TruckHacking/TruckDuckHardware/README.md

The TruckDuck hardware, introduced at the DEFCON24 Talk titled "Cheap Tools for Hacking Heavy Trucks" by SixVolts and Haystack.

Watch the presentation here: https://www.youtube.com/watch?v=PDlkcKtkeOE
