TruckHacking/TruckDuckHardware/Truck Duck Render.png

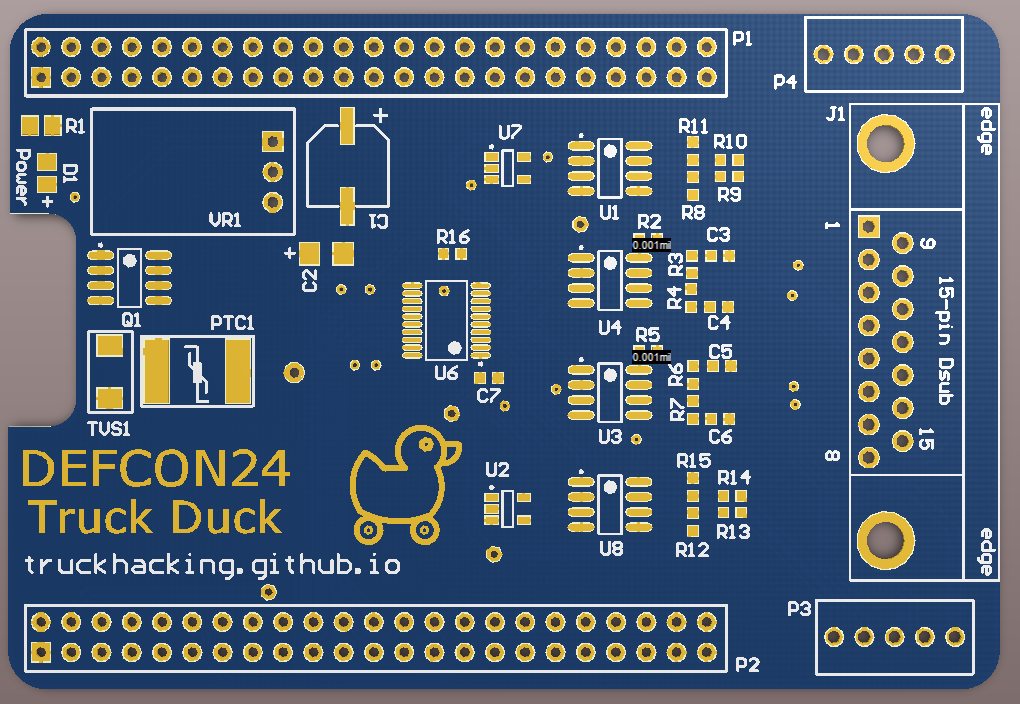
Truck Duck Render.png
