TruckHacking/TruckDuckHardware/Truck Duck Schematics.pdf

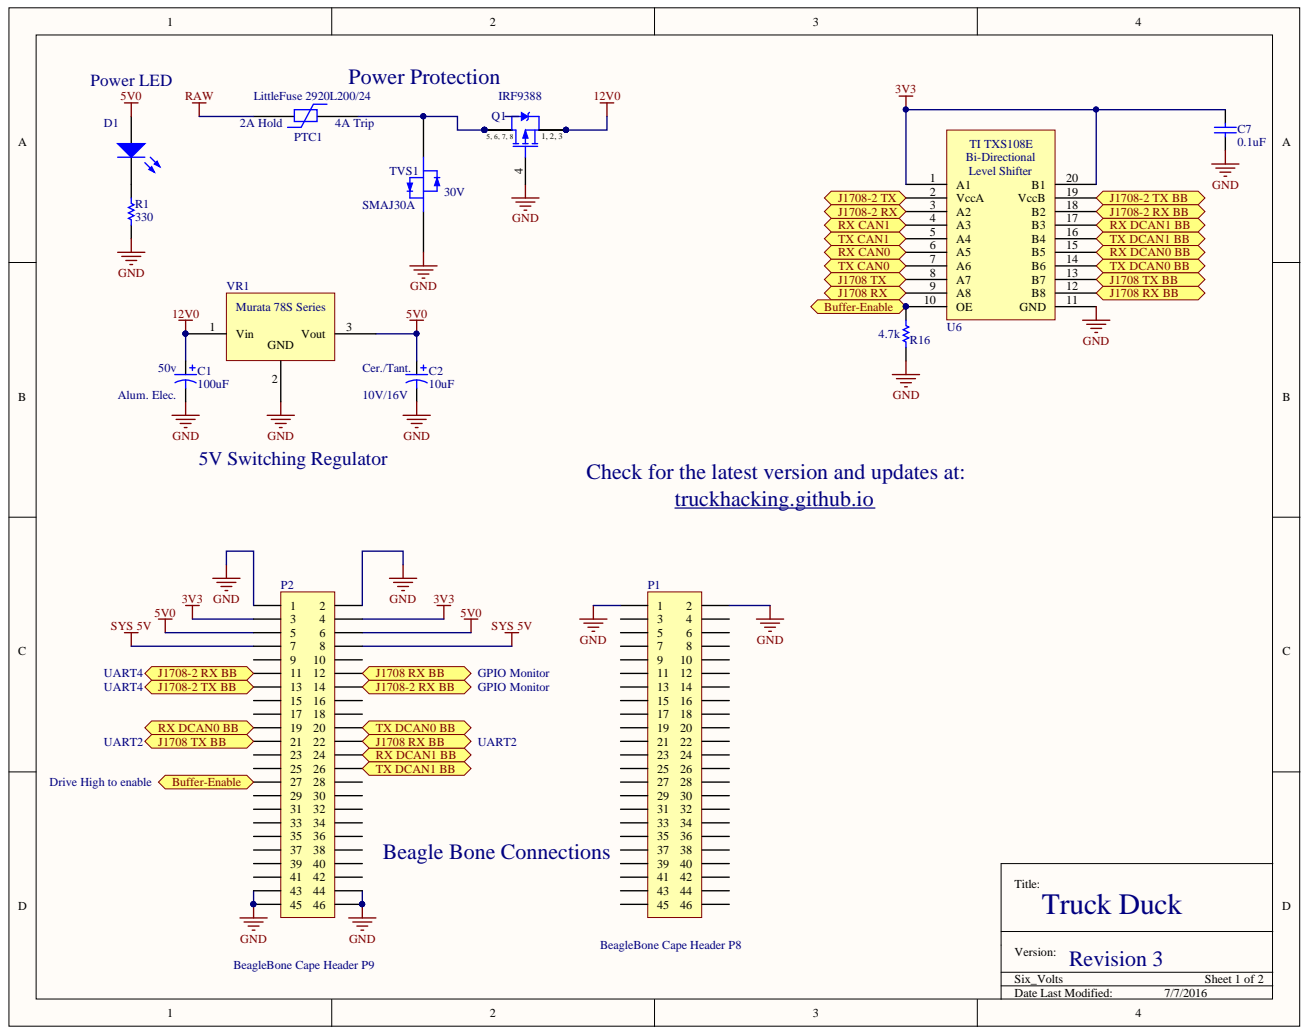
[picture p2: page 1]

Check for the latest version and updates at:

Drive High to enable

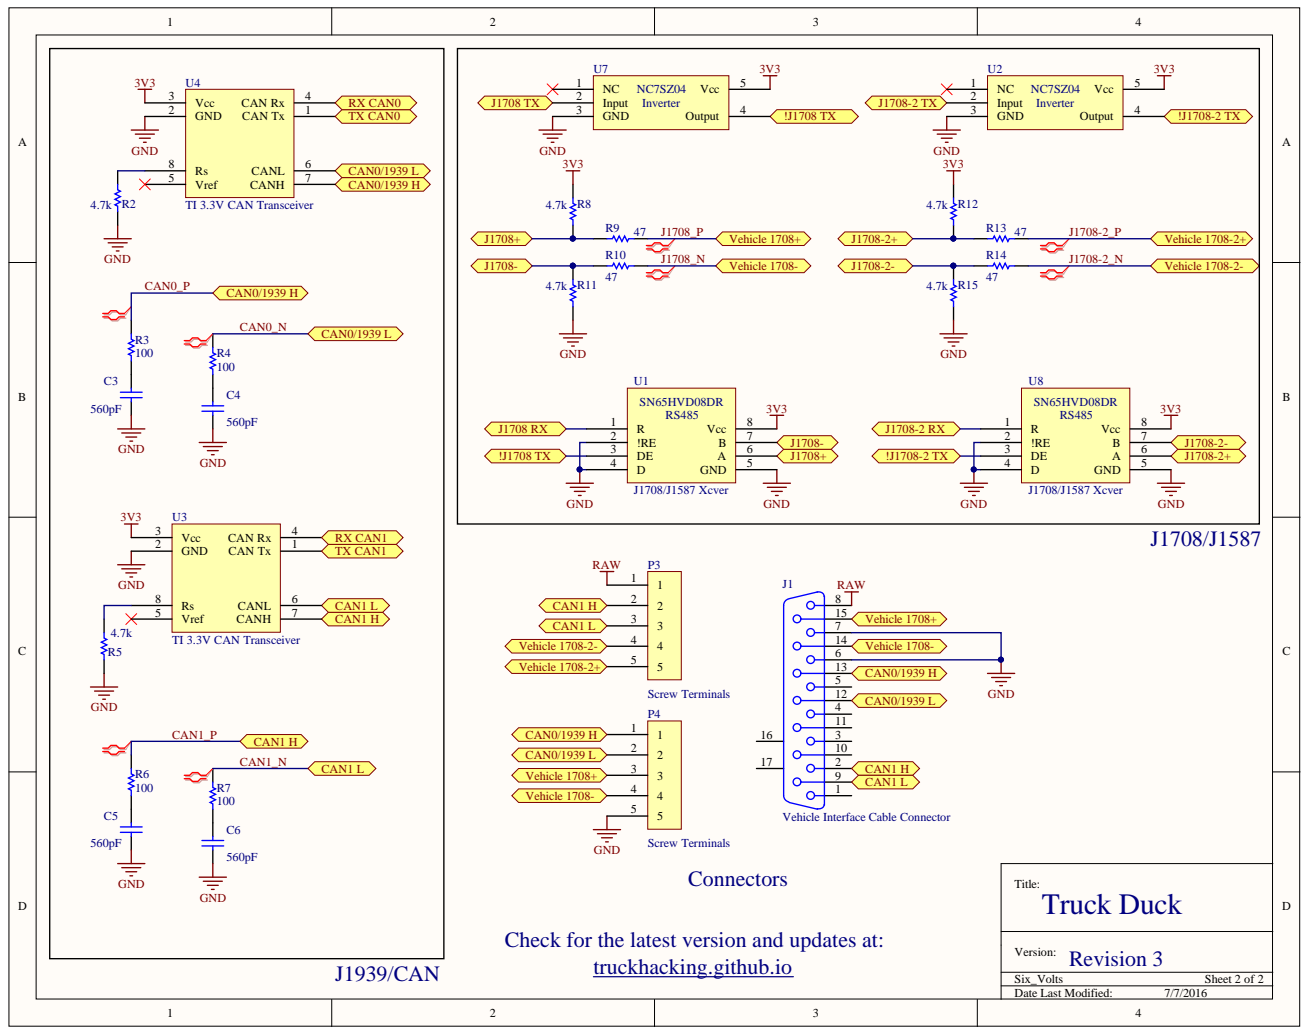
[picture p3: page 2]

Vehicle Interface Cable Connector

Check for the latest version and updates at:
