TruckHacking/TruckDuckHardware/(threads)

Thread 1 (2018-08-06):

Solder paste Gerber layer

pdp7, 2018-08-06:
Hi, I would like to get a stencil made.  Is it possible to get the solder paste Gerber layer?

thanks!
drew

sixvolts, 2018-08-15:
I added the file truck-duck.gtp which I used to make my stencil. Hopefully that works.

pdp7, 2018-08-15:
thanks!

pdp7, 2018-08-15:
@sixvolts I believe we met at Defcon.  I'm happy to do any prototypes you need, just email board size to drew@oshpark.com.  I'm also always interested to get any feedback about the BeagleBone and/or answer questions: drew@beagleboard.org.  Thanks!

Closed 2018-08-15.
