TruckHacking/TruckDuckHardware/(commit log)

2016-08-05 DEFCON 24 Materials
    [truck-duck.drl, truck-duck.gbl, truck-duck.gbo, truck-duck.gbs, truck-duck.gko, truck-duck.gtl, truck-duck.gto, truck-duck.gts]
2016-08-25 added berbers for OBDII adapter
    [cam.drl, obdii-bo.gbl, obdii-bo.gbs, obdii-bo.gko, obdii-bo.gtl, obdii-bo.gto, obdii-bo.gts]
2016-08-28 Added BOM/part numbers for OBDII adapter
2018-08-15 adding paste/stencil gerber
    Added paste/gerber layer
    [truck-duck.gtp]
